NJarosz/PLC_MIGRATION/PLC Architecture and Design.docx

# 1. SYSTEM PHILOSOPHY

You are building an industrial-style PLC architecture with:

- Deterministic real-time control on a microcontroller
- Supervisory Linux layer (Pi)
- External instruction definition (no firmware reflashing)
- Versioned machine behavior
- Strong safety-first philosophy
- Production continuity even during supervisory failure

Core principles:

1. Safety > convenience
2. Deterministic control never depends on Linux
3. Supervisory failure must degrade capability, not safety
4. Configuration is updateable without firmware changes
5. All machine logic must be validated before execution
6. Faults must never be silently ignored

# 2. SYSTEM LAYERS (CLEAR SEPARATION OF RESPONSIBILITIES)

## A. Real-Time Controller (Microcontroller)

Owns:

- Deterministic I/O execution
- Sequence execution engine
- Safety interlocks
- Fault detection
- Watchdogs
- Event logging buffer
- Heartbeat generation
- Local offline operation
- Version verification
- Tick counter / monotonic time

Never depends on:

- Linux filesystem
- Linux scheduler
- Network availability
- Pi uptime

If Pi dies → machine keeps running safely.

## B. Raspberry Pi (Supervisory Layer)

Owns:

- Version store
- Sequence repository
- Validation and compilation pipeline
- PLC registry
- Machine mapping
- Deployment service
- Log ingestion
- CSV archival
- REST API
- UI backend
- Connectivity monitoring
- Management alerting

If Pi dies → no new sequences, logging deferred, but production continues.

## C. Laptop UI

Owns:

- Sequence editor
- Syntax validation
- Human-facing workflow
- Version naming + comments
- Publishing workflow

It does NOT:

- Directly communicate with PLCs
- Store authoritative sequence history
- Deploy firmware

All authoritative storage lives on the Pi.

# 3. SEQUENCE ARCHITECTURE

## Current Format (Human-Facing DSL)

Example:

ON:1

TMR:200

ON:2

TMR:300

OFF:1

OFF:2

This is a human-readable DSL.

# 4. INDUSTRIAL-GRADE INSTRUCTION MODEL

To make this production-grade, it needs 3 distinct representations:

## 1️⃣ Definition (Human Form)

- Editable text (or dropdown UI version)
- Stored as JSON + metadata
- Immutable once published

Metadata includes:

- sequence_id
- version
- author
- timestamp
- comment
- target PLC type
- target machine
- expected channel count

## 2️⃣ Validated IR (Intermediate Representation)

Parsed structure:

[

{op: ON, channel: 1},

{op: TMR, duration_ms: 200},

{op: ON, channel: 2},

]

Semantic validation ensures:

- Channels exist on assigned PLC
- No relay left ON at end
- No double ON
- No OFF before ON
- Timer bounds respected
- Sequence non-empty
- Compatible with PLC hardware profile

Hardware profile must originate from PLC firmware (not editable JSON on Pi).

## 3️⃣ Compiled Binary (Execution Blob)

Compiled into deterministic format:

Example:

[ opcode, arg, opcode, arg, ... ]

This blob:

- Is fixed length
- Is deterministic
- Contains no parsing logic
- Contains no strings
- Contains only verified operations

This is what the PLC executes.

# 5. WHEN DOES COMPILATION HAPPEN?

Best Practice:

When user hits SAVE:

1. Save definition JSON
2. Run semantic validation
3. Compile to binary blob
4. Compute validation hash
5. Store definition + compiled + hash together

Compilation happens ON SAVE.

Deployment happens later.

# 6. VERSIONING MODEL

Each save creates:

sequence_id: weld_cycle_A

version: 3

hash: SHA256(...)

Stored immutably.

Deployment creates a deployment record:

PLC_07 -> weld_cycle_A v3

deployed_at: timestamp

deployed_by: user

Rollback = redeploy previous version.

# 7. VALIDATION HASH

The hash protects against:

- Corruption
- Partial transfer
- Tampering

Flow:

1. Pi computes: SHA256(compiled_blob + metadata)
2. Pi sends:
  - compiled_blob
  - metadata
  - hash
3. PLC:
  - Recomputes SHA256
  - Compares to received hash
  - Rejects if mismatch

This is standard industrial practice.

# 8. REST ARCHITECTURE (PI SIDE)

REST exists ONLY on the Pi.

PLC should expose minimal endpoints — ideally pull-based.

# PI REST ENDPOINT LAYOUT

## Sequence Management

POST /sequences
Create new sequence

GET /sequences
List sequences

GET /sequences/{id}/versions
List versions

GET /sequences/{id}/versions/{v}
Get definition + compiled blob

## PLC Registry

POST /plc/register
Used once at provisioning

GET /plc
List PLCs

GET /plc/{id}
PLC details

POST /plc/{id}/refresh
Trigger deployment check

## Deployment

POST /deployments
Assign sequence version to PLC

GET /deployments/{plc_id}
Get assigned version

## Logging

POST /logs/{plc_id}
PLC pushes event batch

GET /logs/{plc_id}
Query logs

## Health Monitoring

POST /heartbeat/{plc_id}
PLC sends heartbeat

GET /health
System overview

# 9. PLC ↔ PI COMMUNICATION MODEL

### Preferred Model: PLC Pull

Every N seconds:

PLC → GET /deployments/{plc_id}

If new version available:

- Download compiled blob
- Verify hash
- Store
- Acknowledge

Safer than push-based.

# 10. EVENT LOGGING MODEL

Class | Type | Drop Policy
A1 | Fault / Malfunction | NEVER drop
A2 | Logon / Logoff | May drop if buffer full
A3 B | Sequence Run Informational events (WARNS, Recoverable Errors) | May drop if buffer full May drop if buffer full
C | Diagnostic | Lowest priority

# PLC EVENT BUFFER DESIGN

Inside MCU:

- Fixed-size circular buffer
- Separate priority tiers
- A1 queue isolated

If A1 buffer full:
→ Enter FAULT state
→ Halt machine until reconnect/reset

If Pi offline:
→ Buffer continues accumulating
→ On reconnect:

- Batch upload

Production never stops due to internet outage.

# 11. TIMESTAMP STRATEGY

Proposed:

- PLC sends tick counter
- Pi calibrates at first heartbeat
- Pi converts ticks → timestamp

This is absolutely standard.

Industrial systems often use:

- Monotonic tick counter
- Heartbeat sync
- Pi as wall-clock authority

Flow:

1. PLC heartbeat: {tick_count: 182349812}
2. Pi records: (wall_clock_time, plc_tick)
3. Future log: {event, tick_count}
4. Pi computes: timestamp = base_time + (tick_delta)

This avoids clock drift problems.

# 12. HEARTBEAT SYSTEM

PLC → Pi every 5 seconds:

Contains:

- PLC ID
- Current mode
- Active sequence version
- Tick counter
- Fault flag
- Log buffer depth

Pi tracks:

- Last heartbeat time
- Connectivity status

UI can show:

🟢 Connected & Calibrated
🟡 Connected (no calibration yet)
🔴 Offline

# 13. WATCHDOG DESIGN

Two levels:

### A. Internal MCU Watchdog

- Hardware watchdog resets MCU if firmware stalls

### B. Supervisory Watchdog

PLC expects heartbeat ACK
If missing:

- Log A1 supervisory failure
- Continue production
- Raise warning indicator

# 14. DEGRADED MODES

If Pi crashes:

Machine:

- Keeps running
- Logs locally
- Displays supervisory warning
- Continues deterministic execution

If storage corrupted on Pi:

- PLC unaffected

If network lost:

- Logging deferred
- Sequences still run

If PLC detects invalid deployment:

- Reject update
- Keep previous sequence

Safety never compromised.

# 15. PLC HARDWARE PROFILE IMMUTABILITY

You correctly identified a key industrial concern.

Channel metadata must originate from firmware:

Example PLC self-description:

{

digital_outputs: 8,

digital_inputs: 4,

analog_inputs: 2,

max_timer_ms: 8000,

firmware_version: 1.2.3,

hardware_revision: B

}

Pi reads this during registration.

It is NOT editable on Pi.

This prevents misconfiguration.

# 16. MANAGEMENT ALERTING

Supervisory failure detection:

If Pi stops receiving heartbeats:

- Mark PLC offline
- Send alert (email / SMS / dashboard flag)
- Log event

If PLC reports supervisory disconnect:

- Flag supervisory fault
- Notify management

Future: integrate alert service module.

# 17. SECURITY CONSIDERATIONS

POST endpoints must:

- Require authentication
- Validate PLC identity
- Use API keys or certificates
- Restrict network access (local VLAN preferred)

PLC registry POST endpoint vulnerability mitigation:

- Only allow initial provisioning when in setup mode
- Require provisioning token

# 18. USB LOCAL UPDATE (Future v2.0)

Excellent idea.

For no-network scenario:

- Pi exposes USB interface
- Laptop connects directly
- Same REST API accessible locally

Industrial systems often include:

- Service port
- Engineering mode access

# 19. EXECUTION MODEL (INTERPRETED VS COMPILED)

Best practice:

Compile once on Pi
Execute deterministic binary on PLC

Never interpret text on MCU.

Parsing belongs to Linux, not real-time controller.

# 20. FINAL ARCHITECTURAL SUMMARY

✔ Separation of control vs supervision
✔ Deterministic execution engine
✔ Immutable versioned instruction system
✔ Compiled instruction model
✔ Hash verification
✔ Pull-based deployment
✔ Multi-tier event logging
✔ Offline resilience
✔ Heartbeat calibration
✔ Supervisory watchdog
✔ Fault escalation rules
✔ Deployment rollback
✔ Hardware profile enforcement
✔ Alerting hooks

# FIRMWARE DESIGN

┌────────────────────────────────────┐

│ No-Code UI / Config Editor │

│ - Sequence definitions │

│ - Job parameters │

│ - User admin │

└───────────────▲────────────────────┘

│

(files / API)

│

┌───────────────┴────────────────────┐

│ Raspberry Pi (Linux + Python) │

│ │

│ ROLE: Supervisor │

│ - Sequence interpreter │

│ - Operator interaction │

│ - Logging │

│ - Non-safety networking │

│ │

│ CANNOT: │

│ - Drive outputs │

│ - Bypass safety │

└───────────────▲────────────────────┘

│ Deterministic protocol

│ (commands + status)

┌───────────────┴────────────────────┐

│ Microcontroller (Firmware) │

│ │

│ ROLE: Machine Authority │

│ - Safety enforcement │

│ - State machine │

│ - Output control │

│ - Watchdogs │

│ │

│ CAN: │

│ - Reject commands │

│ - Force safe state │

│ - Continue without Linux │

└───────────────▲────────────────────┘

│

┌───────────────┴────────────────────┐

│ Electrical Safety Layer │

│ - E-stop │

│ - Safety relays │

│ - Dual-channel inputs │

└────────────────────────────────────┘

Absolutely — and this is a good instinct. What you’re asking for here is essentially the firmware constitution for your PLC. I’ll give you a clean, structured, but still human-readable summary that captures everything we’ve nailed down so far, plus the implicit design constraints that emerged along the way.

What follows is not code. It’s a design contract. You should be able to hand this to:

- future-you
- a firmware engineer
- an auditor and have them all walk away with the same mental model.

# Firmware Design Master Summary

Modular, No-Code PLC Controller (MCU-Centric Execution Model)

## 1. Core Architectural Philosophy

This system is designed as a real-time, safety-authoritative MCU with an optional non-real-time supervisory system (Linux / Raspberry Pi).

- The MCU is the PLC
- The Pi is a configuration + logging + fleet manager
- Production must continue without the Pi
- Loss of communication must never block or delay machine operation
- Safety and outputs must never depend on Linux

The MCU must be capable of:

- executing sequences deterministically
- enforcing safety unconditionally
- surviving power loss, resets, and communication failures gracefully

## 2. PLC-Style Execution Model

### 2.1 Scan Cycle (Deterministic Main Loop)

The firmware uses a PLC-style cyclic scan, not linear or threaded logic.

Each scan executes in a fixed, repeatable order:

1. Input Sampling (Polling)
  - Read all digital inputs (hand buttons, sensors, etc.)
  - Debounce and normalize input states
  - Snapshot inputs into an internal “process image”
2. Safety Engine
  - Evaluate hard and soft safety conditions
  - Check global safety flags (e-stop, invalid state, watchdog fault)
  - Determine whether outputs are permitted
  - Safety logic has absolute priority
3. State Machine
  - High-level system state:
    - BOOT
    - IDLE
    - ARMED
    - RUNNING
    - FAULT
  - Transitions are explicit and controlled
  - No implicit or hidden transitions
4. Sequence Engine
  - Executes one step of the loaded instruction sequence
  - Only advances if:
    - system state allows it
    - safety is OK
    - step conditions are met
  - Timing (delays, waits) is non-blocking
5. Output Resolution (Gated Outputs)
  - Outputs are not written directly
  - Desired outputs are requested
  - Final output writes are gated by safety state
  - Any unsafe condition forces outputs OFF
6. Logging & Status Update
  - Record significant events (locally)
  - Update heartbeat / status registers

This loop runs continuously and deterministically.

## 3. Interrupts vs Polling (Critical Distinction)

### 3.1 Polling

Used for:

- normal inputs
- sequence conditions
- hand buttons (logical state)

Polling is sufficient for functional control.

### 3.2 Interrupts

Used only for asynchronous, time-critical events, such as:

- E-stop activation
- hardware fault signals
- watchdog warnings

Interrupts:

- DO NOT execute logic
- DO NOT change outputs directly
- ONLY set atomic flags

Example:

- ESTOP_ASSERTED = true

### 3.3 How Interrupts Override the Scan

If an interrupt fires:

- it sets a safety flag immediately
- the current scan may finish
- before outputs are written, gating logic checks flags
- outputs are forced OFF
- next scan transitions to FAULT state

This guarantees:

- deterministic behavior
- no mid-scan race conditions
- no unsafe partial actions

## 4. State Machine Definition

### 4.1 Core States

- BOOT
  - Outputs disabled
  - Hardware initialized
  - No assumptions about prior state
- IDLE
  - Safe state
  - Outputs OFF
  - Waiting for operator action
- ARMED
  - Preconditions met
  - Ready to run
  - No outputs active
- RUNNING
  - Sequence executing
  - Hand buttons trigger cycle start
  - Each cycle is logged
- FAULT
  - Outputs forced OFF
  - Sequence halted
  - Operator acknowledgment required

## 5. Sequence Execution Model

- Entire instruction sequence is downloaded once to MCU
- Sequence stored in MCU memory
- MCU repeats sequence autonomously
- Pi is not involved per scan or per step

### Sequence execution characteristics:

- Step-by-step execution
- Non-blocking delays
- Deterministic timing
- Safe to abort at any point

Example conceptual steps:

- set output
- wait time
- wait for input
- end cycle

## 6. Command & Communication Contract (Pi ↔ MCU)

### 6.1 Design Intent

Communication is:

- decoupled
- non-real-time
- advisory, not authoritative

### 6.2 Pi Responsibilities

- send full instruction sets
- receive logs
- monitor health
- manage multiple MCUs wirelessly
- fleet configuration

### 6.3 MCU Responsibilities

- validate and store sequences
- execute sequences independently
- enforce safety
- operate with zero dependency on Pi

### 6.4 Offline Behavior

- MCU continues normal operation
- No retries or reconnection logic blocks production
- Logs may be buffered or dropped (non-critical)

## 7. Safety Model

### 7.1 Safe State Definition

- All actuators OFF / de-energized
- Outputs default LOW
- No motion, no force, no engagement

### 7.2 Enforcement Layers

1. Hardware defaults
  - pull-downs
  - normally-open contacts
2. Firmware gating
  - output writes conditioned on safety
3. State machine
  - FAULT state locks execution
4. Startup behavior
  - outputs never enabled on boot
  - explicit state required to energize

### 7.3 Startup Sequence

- MCU boots with outputs disabled
- No automatic resumption
- Operator must explicitly re-arm after faults

## 8. Failure Modes & Handling

### 8.1 Power Loss

- Outputs drop immediately
- On restart:
  - system enters FAULT
  - no attempt to resume
  - operator acknowledgment required

### 8.2 MCU Crash / Watchdog Reset

- Watchdog forces reset
- Fault logged locally
- Outputs OFF by default
- System does not resume sequence

### 8.3 Communication Loss

- Logged if possible
- No effect on operation
- No blocking behavior

### 8.4 Partial Sequence Completion

- No recovery logic
- Sequence is aborted
- Safe state enforced
- Operator must restart

## 9. Logging & Observability

### Logged Events (Minimum Set)

- Operator log-in / log-out
- Each sequence run (cycle complete)
- Fault entry
- Reset cause
- Communication loss (best effort)

### Logging Principles

- Local-first
- Non-blocking
- Never interfere with real-time execution
- Transmission to Pi is opportunistic

## 10. Modular Firmware Architecture

### Key Modules

- Hardware Abstraction Layer (HAL)
- Input Manager
- Safety Engine
- State Machine
- Sequence Engine
- Output Gating Layer
- Communications
- Logging
- Watchdog Manager

Modules communicate via:

- shared state structures
- explicit interfaces
- no hidden side effects

## 11. Design Constraints (Non-Negotiables)

- MCU is safety authority
- No blocking calls in scan loop
- No dynamic memory during runtime
- No logic inside interrupts
- Outputs always gated
- Production must continue without Pi

If you want, the next clean step is:

- formalizing this into a one-page architecture diagram
- or translating this into a checklist you can implement firmware against
- or using this as the base prompt for designing the no-code instruction model

This is a very solid foundation. You’re thinking like a controls engineer now — not a hobbyist.
