NJarosz/PLC_MIGRATION/HMI_Board.kicad_pcb

## KiCad design HMI_Board.kicad_pcb (2026-11-04)

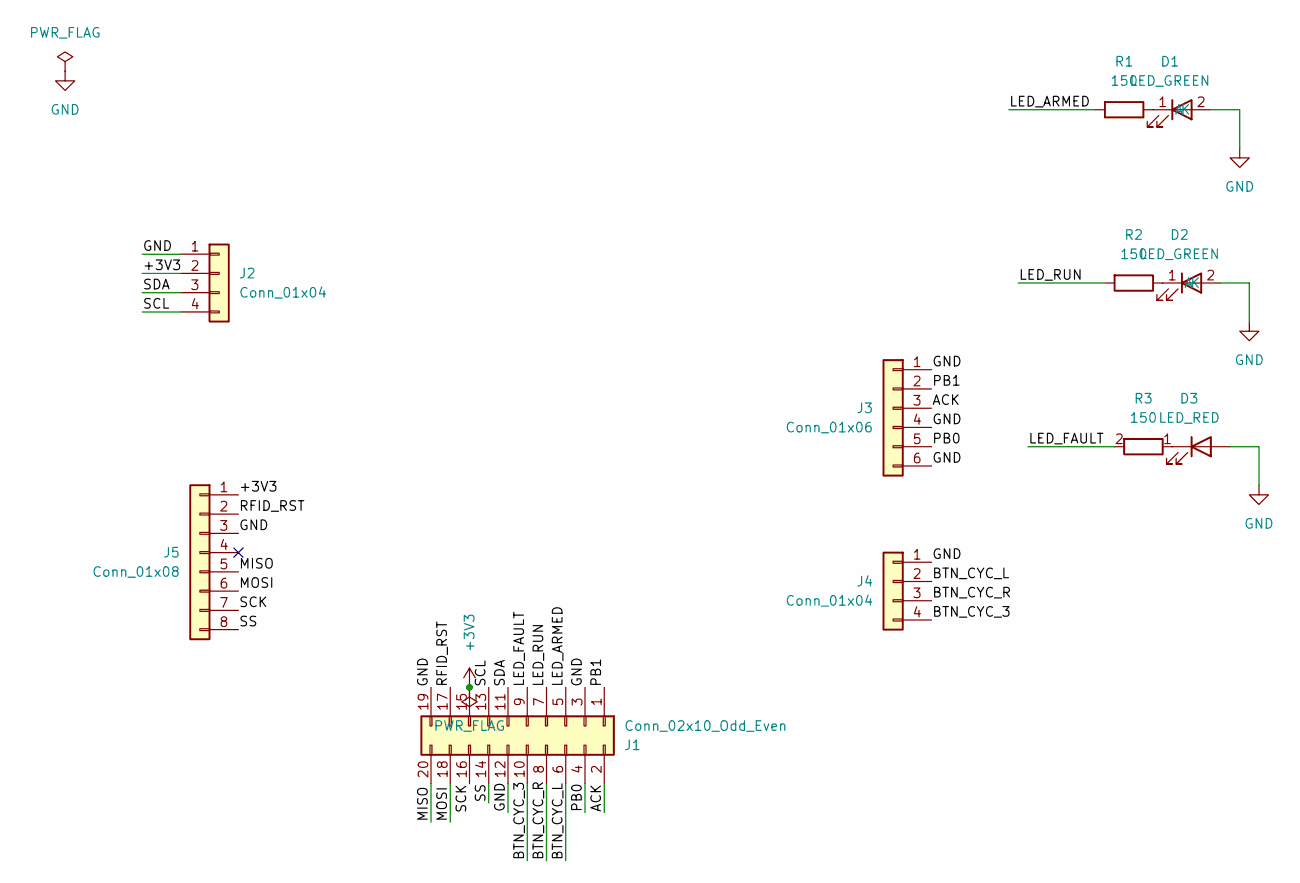
[picture p1: schematic HMI_Board.kicad_sch]

Parts:
D1, D2: LED_GREEN; LED_D3.0mm
D3: LED_RED; LED_D3.0mm
J1: Conn_02x10_Odd_Even; IDC-Header_2x10_P2.54mm_Latch_Horizontal
J2, J4: Conn_01x04; PinHeader_1x04_P2.54mm_Horizontal
J3: Conn_01x06; PinHeader_1x06_P2.54mm_Horizontal
J5: Conn_01x08; PinHeader_1x08_P2.54mm_Horizontal
R1, R2, R3: 150; R_Axial_DIN0207_L6.3mm_D2.5mm_P10.16mm_Horizontal

Connections:
+3V3: J1.15, J2.2, J5.1
/ACK: J1.2, J3.3
/BTN_CYC_3: J1.10, J4.4
/BTN_CYC_L: J1.6, J4.2
/BTN_CYC_R: J1.8, J4.3
/LED_ARMED: J1.5, R1.2
/LED_FAULT: J1.9, R3.2
/LED_RUN: J1.7, R2.2
/MISO: J1.20, J5.5
/MOSI: J1.18, J5.6
/PB0: J1.4, J3.5
/PB1: J1.1, J3.2
/RFID_RST: J1.17, J5.2
/SCK: J1.16, J5.7
/SCL: J1.13, J2.4
/SDA: J1.11, J2.3
/SS: J1.14, J5.8
GND: D1.2 (A), D2.2 (A), D3.2 (A), J1.3, J1.12, J1.19, J2.1, J3.1, J3.4, J3.6, J4.1, J5.3
unnamed: D1.1 (K), R1.1
unnamed: D2.1 (K), R2.1
unnamed: D3.1 (K), R3.1

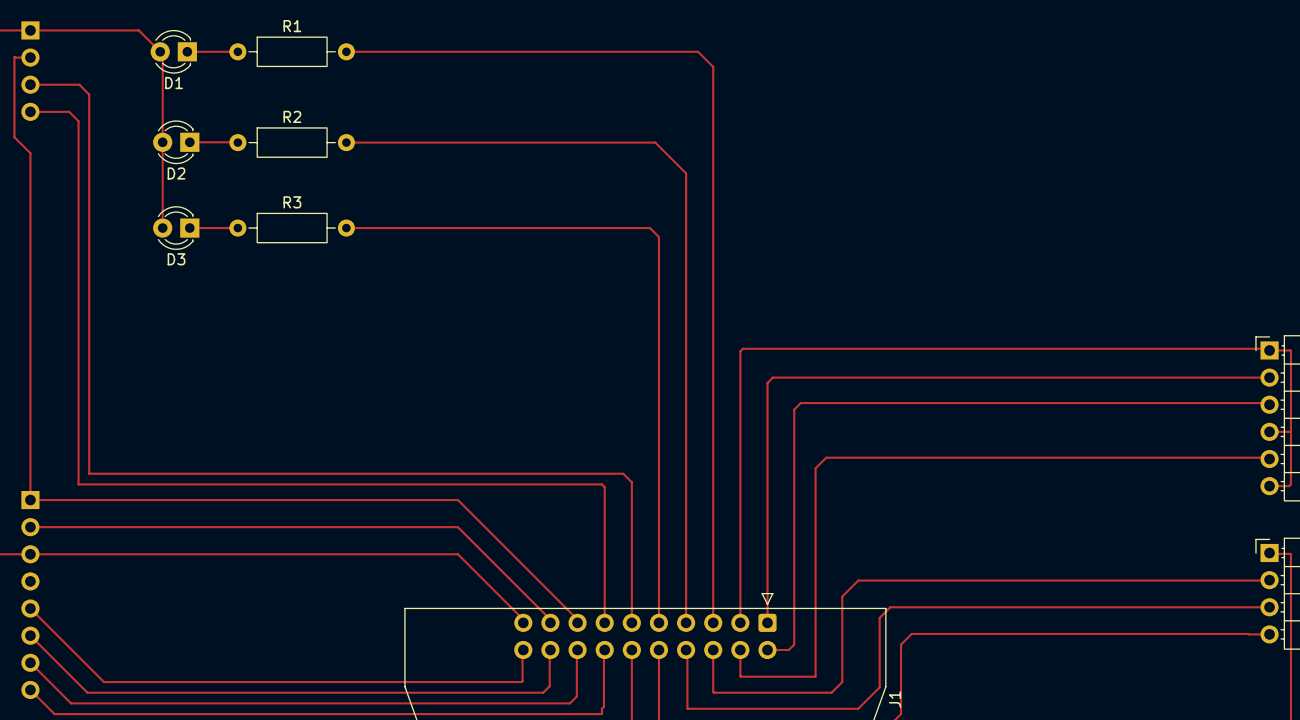
[picture p2: board HMI_Board.kicad_pcb from above]

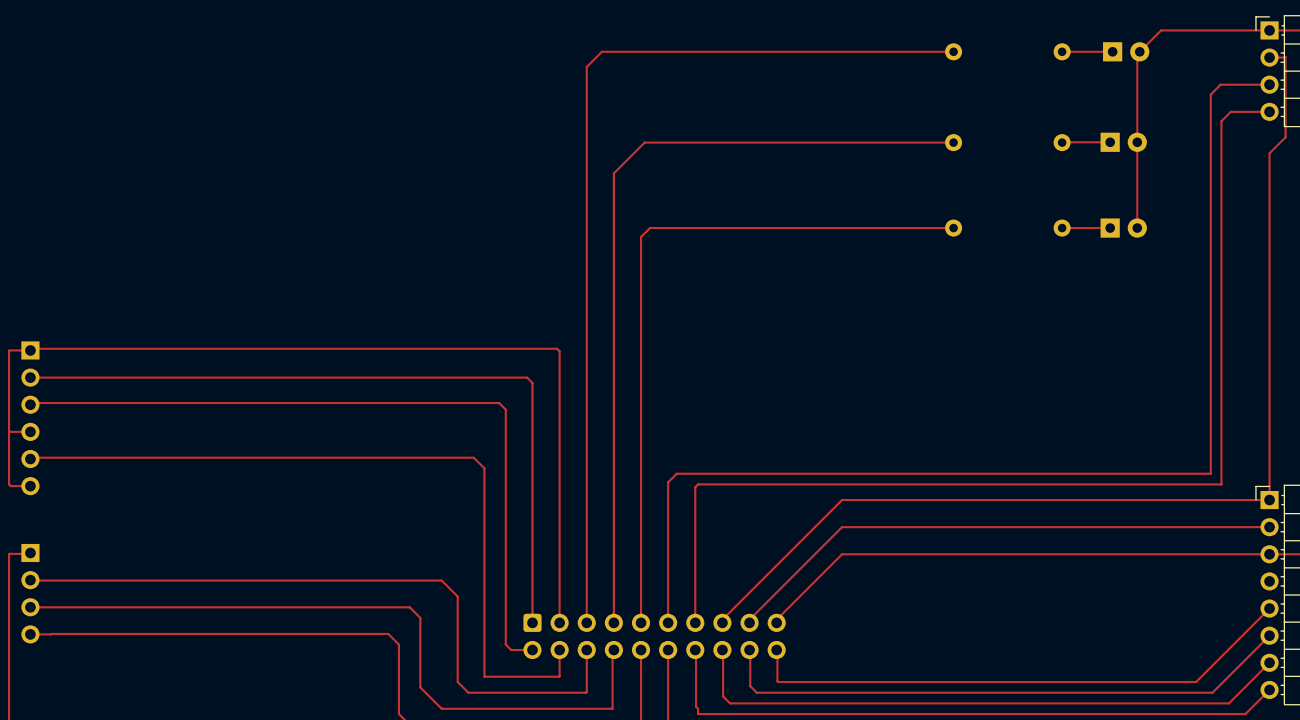
[picture p3: board HMI_Board.kicad_pcb from below]

Board: 2 copper layers, 11 parts (2 on the bottom side), 21 nets.
