NJarosz/PLC_MIGRATION/Core/Inc/main.h

#define B1_Pin GPIO_PIN_13
#define B1_GPIO_Port GPIOC
#define USART_TX_Pin GPIO_PIN_2
#define USART_TX_GPIO_Port GPIOA
#define USART_RX_Pin GPIO_PIN_3
#define USART_RX_GPIO_Port GPIOA
#define LD2_Pin GPIO_PIN_5
#define LD2_GPIO_Port GPIOA
#define RFID_CS_Pin GPIO_PIN_12
#define RFID_CS_GPIO_Port GPIOB
#define RFID_RST_Pin GPIO_PIN_8
#define RFID_RST_GPIO_Port GPIOC
#define TMS_Pin GPIO_PIN_13
#define TMS_GPIO_Port GPIOA
#define TCK_Pin GPIO_PIN_14
#define TCK_GPIO_Port GPIOA
#define SWO_Pin GPIO_PIN_3
#define SWO_GPIO_Port GPIOB
#define RELAY1_Pin GPIO_PIN_0
#define RELAY1_Port GPIOA
#define RELAY2_Pin GPIO_PIN_1
#define RELAY2_Port GPIOA
#define RELAY3_Pin GPIO_PIN_4
#define RELAY3_Port GPIOA
#define RELAY4_Pin GPIO_PIN_5
#define RELAY4_Port GPIOA
#define RELAY5_Pin GPIO_PIN_6
#define RELAY5_Port GPIOA
#define RELAY6_Pin GPIO_PIN_7
#define RELAY6_Port GPIOA
#define RELAY7_Pin GPIO_PIN_8
#define RELAY7_Port GPIOA
#define RELAY8_Pin GPIO_PIN_11
#define RELAY8_Port GPIOA
#define NUM_RELAYS 8
#define RUN_Pin          GPIO_PIN_0
#define RUN_Port         GPIOB
#define FETCH_Pin        GPIO_PIN_1
#define FETCH_Port       GPIOB
#define ACK_BTN_Pin      GPIO_PIN_10
#define ACK_BTN_GPIO_Port GPIOB
#define ESTOP_Pin        GPIO_PIN_4
#define ESTOP_Port       GPIOB
#define BTN_CYC_L_Pin    GPIO_PIN_14
#define BTN_CYC_L_Port   GPIOB
#define BTN_CYC_R_Pin    GPIO_PIN_15
#define BTN_CYC_R_Port   GPIOB
#define BTN_CYC_3_Pin    GPIO_PIN_11
#define BTN_CYC_3_Port   GPIOC
#define MAN_SW1_Pin   GPIO_PIN_3
#define MAN_SW1_Port  GPIOC
#define MAN_SW2_Pin   GPIO_PIN_4
#define MAN_SW2_Port  GPIOC
#define MAN_SW3_Pin   GPIO_PIN_5
#define MAN_SW3_Port  GPIOC
#define MAN_SW4_Pin   GPIO_PIN_6
#define MAN_SW4_Port  GPIOC
#define MAN_SW5_Pin   GPIO_PIN_7
#define MAN_SW5_Port  GPIOC
#define MAN_SW6_Pin   GPIO_PIN_8
#define MAN_SW6_Port  GPIOC
#define MAN_SW7_Pin   GPIO_PIN_9
#define MAN_SW7_Port  GPIOC
#define MAN_SW8_Pin   GPIO_PIN_10
#define MAN_SW8_Port  GPIOC
#define RFID_CS_Pin    GPIO_PIN_12
#define RFID_CS_Port   GPIOB
#define RFID_RST_Pin   GPIO_PIN_12
#define RFID_RST_Port  GPIOA
#define ESP_TX_Pin GPIO_PIN_9
#define ESP_TX_GPIO_Port GPIOA
#define ESP_RX_Pin GPIO_PIN_10
#define ESP_RX_GPIO_Port GPIOA
#define LED_ARMED_Pin   GPIO_PIN_5
#define LED_ARMED_Port  GPIOB
#define LED_RUN_Pin     GPIO_PIN_7
#define LED_RUN_Port    GPIOB
#define LED_FAULT_Pin   GPIO_PIN_6
#define LED_FAULT_Port  GPIOB
