NJarosz/PLC_MIGRATION/Core/Src/main.c

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
/* Includes ------------------------------------------------------------------*/
#include "main.h"
#include "i2c.h"
#include "iwdg.h"
#include "spi.h"
#include "usart.h"
#include "gpio.h"

/* USER CODE BEGIN Includes */
#include <stdbool.h>
#include "usart.h"
#include "gpio.h"
#include "lcd.h"
#include "supervisor_comms.h"
#include "inputs.h"
#include "mfrc522.h"
#include "logger.h"
#include "outputs.h"
#include "safety.h"
#include "sequence_engine.h"
#include "sequence_storage.h"
#include "state_machine.h"
/* USER CODE END Includes */


void SystemClock_Config(void);
/**
  * @brief  The application entry point.
  * @retval int
  */
int main(void)
{
  /* MCU Configuration--------------------------------------------------------*/

  /* Reset of all peripherals, Initializes the Flash interface and the Systick. */
  HAL_Init();

  /* Configure the system clock */
  SystemClock_Config();

  /* Initialize all configured peripherals */
  MX_GPIO_Init();
  MX_USART2_UART_Init();
  MX_IWDG_Init();
  MX_USART1_UART_Init();
  MX_SPI2_Init();
  MX_I2C1_Init();
  /* USER CODE BEGIN 2 */

  // Initialize modules
  MFRC522_Init();
  LCD_Init();
  Inputs_Init();
  Outputs_Init();
  Safety_Init();
  Logger_Init();

  // Detect and log watchdog reset — must happen right after Logger_Init so the event is captured
  if (__HAL_RCC_GET_FLAG(RCC_FLAG_IWDGRST)) {
      Logger_Log(LOG_TIER_A1, EVENT_WATCHDOG_RESET, 0);
  }
  __HAL_RCC_CLEAR_RESET_FLAGS();  // clear all reset source flags for next boot

  StateMachine_Init();
  SequenceEngine_Init();
  SequenceStorage_Load();  // Restore last sequence from flash
  SupervisorComms_Init();

  /* USER CODE END 2 */

  /* Infinite loop */
  /* USER CODE BEGIN WHILE */
  while (1)
  {

    // PLC-style scan cycle
	HAL_IWDG_Refresh(&hiwdg);  // Prevent reset; call early each scan

    Inputs_Update();  // Sample inputs

    bool safety_ok = Safety_IsOK();  // Evaluate safety

    StateMachine_Update(safety_ok);  // Update state machine

    SequenceEngine_Update();  // Update sequence if running

    Outputs_Apply(safety_ok);  // Apply gated outputs
    Outputs_UpdateLEDs(system_state.state);  // Update HMI panel LEDs

    SupervisorComms_Task();  // ESP32 comms: heartbeat, log upload, sequence receive

    HAL_Delay(10);  // Minimal delay for scan rate; adjust for determinism

    /* USER CODE END WHILE */

    /* USER CODE BEGIN 3 */
  }
  /* USER CODE END 3 */
}

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
/* USER CODE BEGIN 4 */

int _write(int file, char *ptr, int len)
{
    HAL_UART_Transmit(&huart2, (uint8_t*)ptr, len, HAL_MAX_DELAY);
    return len;
}

/* USER CODE END 4 */
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
