NJarosz/PLC_MIGRATION/Core/Src/supervisor_comms.c

#include "supervisor_comms.h"
#include "main.h"               // for huart1
#include "sequence_storage.h"
#include "sequence_engine.h"
#include "state_machine.h"
#include "safety.h"
#include "logger.h"
#include "sha256.h"
#include "usart.h"
#include "lcd.h"
#include <string.h>
#include <stdio.h>
#include <stdint.h>
#include <stdlib.h>

#define START_BYTE 0xAA
#define END_BYTE   0x55
#define HEARTBEAT_INTERVAL_MS 5000  // 5s

typedef enum {
    RX_WAIT_START,
    RX_WAIT_LEN,
    RX_WAIT_META,    // collect META_SIZE bytes of metadata after LEN
    RX_WAIT_PAYLOAD,
    RX_WAIT_HASH,    // collect SHA256_BLOCK_SIZE bytes after payload
    RX_WAIT_END
} RxState_t;

static RxState_t rx_state = RX_WAIT_START;
static uint8_t rx_len = 0;
static uint8_t rx_idx = 0;
static uint8_t rx_buffer[256];

static uint32_t last_heartbeat = 0;
static bool connected = false;
static char active_seq_name[16] = "none";  // updated on every successful sequence receive
static char active_part_num[12] = "";      // updated on every successful sequence receive
static volatile bool upload_requested = false;
static char operator_name[32] = "";
static uint16_t run_count  = 0;
static uint16_t count_goal = 0;  // 0 = no goal active
static bool boot_heartbeat_pending = true;  // cleared after first heartbeat; Pi uses it to restore count
static bool new_sequence_available = false;

void SupervisorComms_RequestUpload(void) {
    upload_requested = true;
}

void SupervisorComms_SetActiveSeqName(const char *name) {
    strncpy(active_seq_name, name, sizeof(active_seq_name) - 1);
    active_seq_name[sizeof(active_seq_name) - 1] = '\0';
}

const char* SupervisorComms_GetActiveSeqName(void) {
    return active_seq_name;
}

void SupervisorComms_SetPartNum(const char *part_num) {
    strncpy(active_part_num, part_num, sizeof(active_part_num) - 1);
    active_part_num[sizeof(active_part_num) - 1] = '\0';
}

const char* SupervisorComms_GetPartNum(void) {
    return active_part_num;
}

bool SupervisorComms_NewSequenceAvailable(void) { return new_sequence_available; }
void SupervisorComms_ClearNewSequence(void)      { new_sequence_available = false; }

void SupervisorComms_LookupEmployee(uint32_t employee_id) {
    char msg[32];
    int len = snprintf(msg, sizeof(msg), "LOOKUP_EMPLOYEE|%lu\r\n", (unsigned long)employee_id);
    HAL_UART_Transmit(&huart1, (uint8_t*)msg, (uint16_t)len, 50);
}

const char* SupervisorComms_GetOperatorName(void) {
    return operator_name;
}

void SupervisorComms_ClearOperatorName(void) {
    operator_name[0] = '\0';
}

void SupervisorComms_IncrementCount(void)       { run_count++; }
void SupervisorComms_ResetCount(void)           { run_count = 0; }
void SupervisorComms_SetCount(uint16_t count)   { run_count = count; }
uint16_t SupervisorComms_GetCount(void)         { return run_count; }
uint16_t SupervisorComms_GetGoal(void)          { return count_goal; }
bool SupervisorComms_IsGoalReached(void)        { return count_goal > 0 && run_count >= count_goal; }
void SupervisorComms_SetGoal(uint16_t goal)     { count_goal = goal; }

static void HandleIncomingLine(const char *line) {
    if (strncmp(line, "EMPLOYEE_NAME|", 14) == 0) {
        const char *name = line + 14;
        strncpy(operator_name, name, sizeof(operator_name) - 1);
        operator_name[sizeof(operator_name) - 1] = '\0';
        LCD_ShowArmed(operator_name, run_count, count_goal, active_part_num);
    } else if (strncmp(line, "SET_GOAL|", 9) == 0) {
        count_goal = (uint16_t)atoi(line + 9);
    } else if (strncmp(line, "SET_COUNT|", 10) == 0) {
        run_count = (uint16_t)atoi(line + 10);
    } else if (strncmp(line, "SET_PART|", 9) == 0) {
        strncpy(active_part_num, line + 9, sizeof(active_part_num) - 1);
        active_part_num[sizeof(active_part_num) - 1] = '\0';
    }
}

static void UploadLogs_UART1(void)
{
    static LogEvent_t drain_buf[LOG_MAX_DRAIN];
    uint16_t count = Logger_Drain(drain_buf, LOG_MAX_DRAIN);
    if (count == 0) return;

    HAL_UART_Transmit(&huart1, (uint8_t*)"UPLOAD_LOGS\r\n", 13, 100);

    char line[48];
    for (uint16_t i = 0; i < count; i++) {
        int len = snprintf(line, sizeof(line), "%lu,%d,%u,%lu\r\n",
                           (unsigned long)drain_buf[i].timestamp_ms,
                           (int)drain_buf[i].tier,
                           drain_buf[i].event_code,
                           (unsigned long)drain_buf[i].data);
        HAL_UART_Transmit(&huart1, (uint8_t*)line, (uint16_t)len, 50);
    }

    HAL_UART_Transmit(&huart1, (uint8_t*)"LOGS_END\r\n", 10, 100);
}


// Format: HEARTBEAT|<tick_ms>|<state>|<seq_name>|<fault>|<count>|<boot>\r\n
// boot=1 on the first heartbeat after power-on; Pi uses it to restore the stored count.
// State codes: 0=BOOT 1=IDLE 2=ARMED 3=RUNNING 4=FAULT 5=GOAL_MET
static void SendHeartbeat(void)
{
    char line[80];
    uint8_t fault_flag = (FAULT_LATCHED || system_state.state == STATE_FAULT) ? 1 : 0;
    uint8_t boot_flag  = boot_heartbeat_pending ? 1 : 0;

    int len = snprintf(line, sizeof(line), "HEARTBEAT|%lu|%u|%s|%u|%u|%u\r\n",
                       (unsigned long)HAL_GetTick(),
                       (unsigned int)system_state.state,
                       active_seq_name,
                       fault_flag,
                       run_count,
                       boot_flag);
    HAL_UART_Transmit(&huart1, (uint8_t*)line, (uint16_t)len, 50);
    boot_heartbeat_pending = false;
}


void SupervisorComms_Init(void) {
    // Optional: ESP reset pin if available
    last_heartbeat = HAL_GetTick();
    connected = false;
}

bool SupervisorComms_IsConnected(void) {
    return connected;
}


// Call this when operator wants a new sequence (e.g. button press in IDLE)
void RequestNewSequence(void)
{
    const char *request = "REQUEST_SEQUENCE\r\n";
    HAL_UART_Transmit(&huart1, (uint8_t*)request, strlen(request), 100);
    Logger_Log(LOG_TIER_B, EVENT_SEQUENCE_REQUESTED, 0);
}


void SupervisorComms_Task(void)
{
    static bool first_run = true;
    if (first_run) {
        uint8_t tmp;
        while (HAL_UART_Receive(&huart1, &tmp, 1, 10) == HAL_OK);  // flush junk
        first_run = false;
    }

    if (upload_requested) {
        upload_requested = false;
        UploadLogs_UART1();
    }

    uint8_t byte;
    static uint32_t last_rx_time = 0;
    static uint8_t capture_buffer[256];
    static uint8_t capture_idx = 0;
    static bool capturing = false;
    static char text_line_buf[64];
    static uint8_t text_line_idx = 0;

    HAL_StatusTypeDef rx_status;

    while ((rx_status = HAL_UART_Receive(&huart1, &byte, 1, 0)) == HAL_OK)
    {
        last_rx_time = HAL_GetTick();

        if (byte == START_BYTE && !capturing) {
            text_line_idx = 0;  // discard any partial text line
            capture_idx = 0;
            capturing = true;
            capture_buffer[capture_idx++] = byte;
            rx_state = RX_WAIT_LEN;
            continue;
        }

        if (!capturing) {
            // Buffer text lines (EMPLOYEE_NAME| responses etc.)
            if (byte == '\n') {
                if (text_line_idx > 0 && text_line_buf[text_line_idx - 1] == '\r') {
                    text_line_idx--;
                }
                text_line_buf[text_line_idx] = '\0';
                if (text_line_idx > 0) {
                    HandleIncomingLine(text_line_buf);
                }
                text_line_idx = 0;
            } else if (text_line_idx < sizeof(text_line_buf) - 1) {
                text_line_buf[text_line_idx++] = byte;
            }
            continue;
        }

        if (capturing) {
            capture_buffer[capture_idx++] = byte;

            if (capture_idx >= 2 && rx_state == RX_WAIT_LEN) {
                rx_len = capture_buffer[1];
                rx_state = RX_WAIT_META;
            }

            if (rx_state == RX_WAIT_META &&
                capture_idx >= (2 + META_SIZE)) {
                rx_state = RX_WAIT_PAYLOAD;
            }

            if (rx_state == RX_WAIT_PAYLOAD &&
                capture_idx >= (2 + META_SIZE + rx_len)) {
                rx_state = RX_WAIT_HASH;
            }

            if (rx_state == RX_WAIT_HASH &&
                capture_idx >= (2 + META_SIZE + rx_len + SHA256_BLOCK_SIZE)) {
                rx_state = RX_WAIT_END;
            }

            if (rx_state == RX_WAIT_END && byte == END_BYTE) {
                // Verify SHA-256: hash covers meta + blob
                uint8_t computed_hash[SHA256_BLOCK_SIZE];
                SHA256_CTX sha_ctx;
                sha256_init(&sha_ctx);
                sha256_update(&sha_ctx, &capture_buffer[2], META_SIZE + rx_len);
                sha256_final(&sha_ctx, computed_hash);

                const uint8_t *received_hash = &capture_buffer[2 + META_SIZE + rx_len];

                if (memcmp(computed_hash, received_hash, SHA256_BLOCK_SIZE) != 0) {
                    Logger_Log(LOG_TIER_B, EVENT_COMMS_HASH_MISMATCH, 0);
                    capturing = false;
                    rx_state = RX_WAIT_START;
                } else if (rx_len > 0 && rx_len % sizeof(SequenceStep_t) == 0) {
                    // Parse and validate metadata
                    SequenceMetadata_t meta;
                    memcpy(&meta, &capture_buffer[2], META_SIZE);
                    uint8_t expected_steps = rx_len / sizeof(SequenceStep_t);

                    if (meta.step_count != expected_steps) {
                        Logger_Log(LOG_TIER_B, EVENT_COMMS_META_INVALID, meta.step_count);
                        capturing = false;
                        rx_state = RX_WAIT_START;
                    } else {
                        SequenceStep_t steps[MAX_SEQUENCE_STEPS];
                        memcpy(steps, &capture_buffer[2 + META_SIZE], rx_len);
                        SequenceStorage_Save(steps, expected_steps, &meta);
                        Logger_Log(LOG_TIER_B, EVENT_SEQUENCE_RECEIVED, expected_steps);

                        // Track active sequence name for heartbeat reporting
                        memcpy(active_seq_name, meta.seq_name, sizeof(active_seq_name) - 1);
                        active_seq_name[sizeof(active_seq_name) - 1] = '\0';
                        new_sequence_available = true;

                        UploadLogs_UART1();  // ship buffered logs to Pi before idling

                        // LCD mock — replace with actual LCD driver calls when hardware is ready
                        printf("--- SEQUENCE LOADED ---\r\n");
                        printf("Seq : %.*s\r\n",  15, (char*)meta.seq_name);
                        printf("Part: %.*s\r\n",  11, (char*)meta.part_num);
                        printf("Mach: %.*s\r\n",   7, (char*)meta.machine_id);
                        printf("Steps: %u  v%u\r\n", expected_steps, meta.version);
                        printf("-----------------------\r\n");

                        capturing = false;
                        rx_state = RX_WAIT_START;
                    }
                } else {
                    Logger_Log(LOG_TIER_B, EVENT_COMMS_FRAME_INVALID, rx_len);
                    capturing = false;
                    rx_state = RX_WAIT_START;
                }
            }
        }
    }

    if (rx_status == HAL_ERROR) {
        Logger_Log(LOG_TIER_B, EVENT_COMMS_UART_ERROR, huart1.Instance->SR);
    }

    // Timeout safety
    if (capturing && (HAL_GetTick() - last_rx_time > 800)) {
        Logger_Log(LOG_TIER_B, EVENT_COMMS_RX_TIMEOUT, capture_idx);
        capturing = false;
        rx_state = RX_WAIT_START;
    }

    // Heartbeat TX — every 5s, non-blocking
    uint32_t now = HAL_GetTick();
    if (now - last_heartbeat >= HEARTBEAT_INTERVAL_MS) {
        SendHeartbeat();
        last_heartbeat = now;
    }
}
