NJarosz/PLC_MIGRATION/Core/Inc/lcd.h

#ifndef LCD_H
#define LCD_H

#include <stdint.h>
#include <stdbool.h>

void LCD_Init(void);
void LCD_Clear(void);
void LCD_SetCursor(uint8_t col, uint8_t row);
void LCD_Print(const char *str);
void LCD_PrintChar(char c);

// State display helpers — call at each state transition
void LCD_ShowIdle(const char *seq_name, uint16_t count, const char *part_num);
void LCD_ShowNewSequence(const char *seq_name);   // alternates with ShowIdle every 5 s
void LCD_ShowArmed(const char *operator_display, uint16_t count, uint16_t goal, const char *part_num);
void LCD_ShowRunning(const char *seq_name, uint16_t count, uint16_t goal);
void LCD_ShowGoalReached(uint16_t count, uint16_t goal);
void LCD_ShowCountResetConfirm(uint16_t count);
void LCD_ShowFault(void);
void LCD_ShowManual(const bool *relay_states, uint8_t count);

#endif
