NJarosz/PLC_MIGRATION/(commit log)

2026-04-16 updated compiler / sequence format to be more human readable, bypassing bitmask values and using an array of relay values
2026-05-07 more UI functionality. fix deploy button on seq screen and card layout
2026-05-13 Updated count to be persistent, also added a second user button and adjusted button functionality
