NJarosz/PLC_MIGRATION/(notices)

Notices in the files:
Core/Src/main.c:
Copyright (c) 2026 STMicroelectronics.
All rights reserved.
This software is licensed under terms that can be found in the LICENSE file in
Core/Inc/main.h:
This software is licensed under terms that can be found in the LICENSE file
